haydenmc/button-boi/cad/Enclosure.FCStd

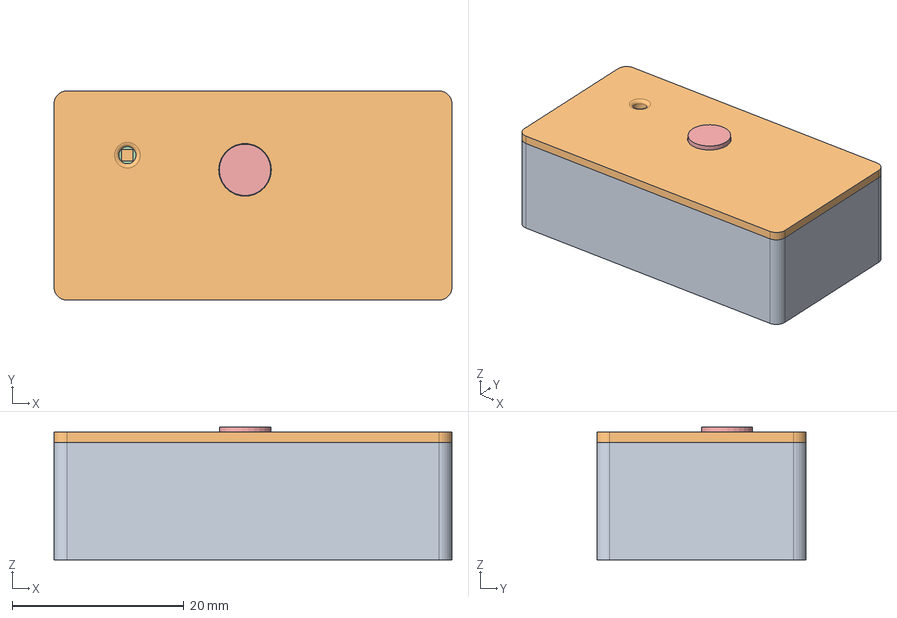
[picture p1: CAD file, 2026-11-09]
cad/Enclosure.FCStd
46.4 x 24.4 x 15.5 mm
Base
Lid
TinyS3_P8_V2_AT2450AT18B100 PCB
Button
