haydenmc/button-boi/(commit log)

2026-11-07 Add button-boi prototype firmware and Web Bluetooth client
    ESP-IDF firmware for the TinyS3 (ESP32-S3) that logs a timestamp to flash on
    each button press and spends the rest of its time in deep sleep.
    - Short press: wake via EXT1, append a 16-byte record to a 64 KB flash ring
    log (CRC + sequence numbers, torn-write tolerant), flash LED, sleep
    - Long press (3 s): BLE sync window (NimBLE GATT) to set the clock, dump
    records and erase the log
    - Sessions + TIME_SYNC records let the client turn uptime-only records into
    wall-clock time and correct RTC drift
    - Build-time Kconfig options for button GPIO/level/pull, LED type (none,
    GPIO, WS2812 with power-enable pin), timings and debug no-sl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
    [partitions.csv]
2026-11-07 Report battery voltage and USB power over BLE
    Sample the TinyS3 VBAT divider (GPIO10, 442k/160k) with the calibrated ADC
    when sync mode starts, before the radio is on, and read USB presence from
    GPIO33. Both are appended to the Info characteristic (31 bytes; older
    clients still read the first 28). The web page shows voltage and an
    approximate LiPo percentage, or "USB power" when the charger is active.
    Pins and divider values are Kconfig options under "Battery".
2026-11-08 Add early enclosure design
    [Enclosure.FCStd]
2026-11-09 Update enclosure with button and LED passthrough
    [Enclosure.FCStd]
2026-11-09 Adjust enclosure to tighten tolerances and provide a smidge more battery room
    [Enclosure.FCStd]
2026-11-09 Enclosure changes to improve print quality
    [Enclosure.FCStd]
